ytai/PixieGuitar/hardware/Controller.brd

## EAGLE design hardware/Controller.brd (2016-02-16)

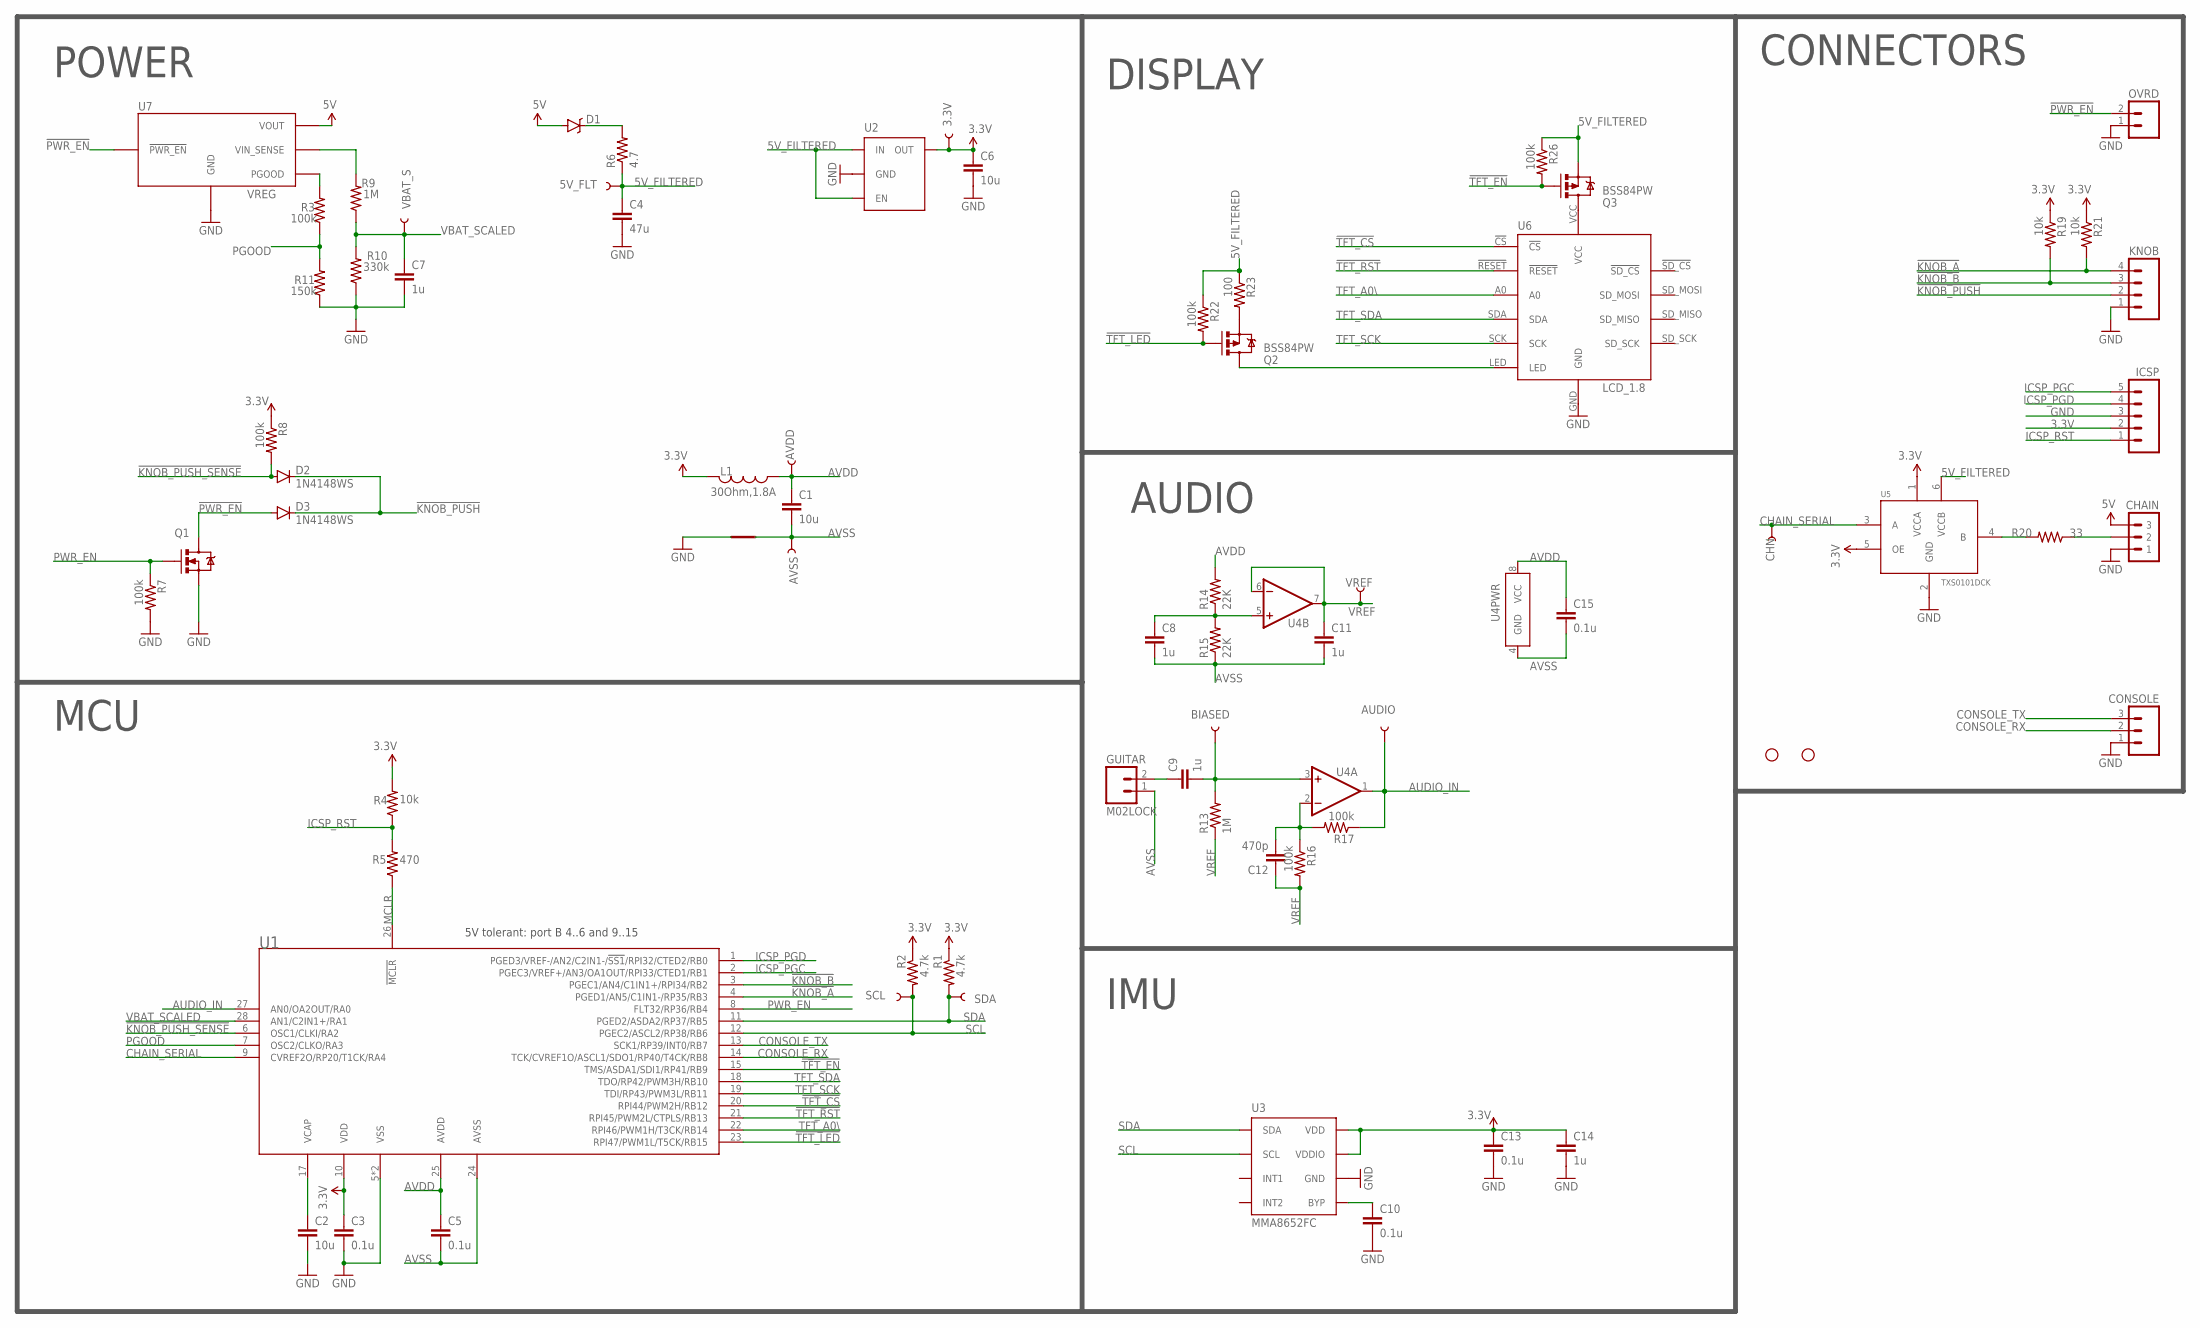
[picture p1: schematic Controller.sch]

Parts:
3.3V, 5V_FLT: TEST-POINT3; PAD.03X.03
AUDIO: TEST-POINT3; PAD.03X.03
AVDD: TEST-POINT3; PAD.03X.03
AVSS: TEST-POINT3; PAD.03X.03
BIASED: TEST-POINT3; PAD.03X.03
C1, C2: 10u; 0805
C3, C5, C10, C13, C15: 0.1u; 0603-CAP
C4: 47u; 1206
C6: 10u; 0603-CAP
C7, C8, C9, C11, C14: 1u; 0603-CAP
C12: 470p; 0603-CAP
CHAIN: M030.1PWR+SIG; 1X03-0.1PWR+SIG
CHN: TEST-POINT3; PAD.03X.03
CONSOLE: M03LOCK; 1X03_LOCK
D1: DB2J20900L; SOD-323
D2, D3: 1N4148WS; SOD-323
GUITAR: M02LOCK; 1X02_LOCK
ICSP: M05LOCK; 1X05_LOCK
JP1, JP2: STAND-OFF
KNOB: M04LOCK; 1X04_LOCK
L1: 30Ohm,1.8A; 0603
OVRD: M02LOCK; 1X02_LOCK
Q1: MOSFET-NCHANNEL2N7002PW; SOT323
Q2, Q3: BSS84PW; SOT323
R1, R2: 4.7k; 0603-RES
R3, R7, R8, R16, R17, R22, R26: 100k; 0603-RES
R4, R19, R21: 10k; 0603-RES
R5: 470; 0603-RES
R6: 4.7; 0603-RES
R9, R13: 1M; 0603-RES
R10: 330k; 0603-RES
R11: 150k; 0603-RES
R14, R15: 22K; 0603-RES
R20: 33; 0603-RES
R23: 100; 0603-RES
SCL: TEST-POINT3; PAD.03X.03
SDA: TEST-POINT3; PAD.03X.03
SH1: SHORT; SHORT_TOP-8
U1: DSPIC33EPXXXMC202/502/PT; QFN-S-28
U2: MIC5365YC5; SC70
U3: MMA8652FC; 10-VFDFN
U4: MCP6002MS; MSOP-8
U5: TXS0101DCK; SC70-6
U6: LCD_1.8
U7: VREG
VBAT_S: TEST-POINT3; PAD.03X.03
VREF: TEST-POINT3; PAD.03X.03

Connections:
3.3V: 3.3V.P$1, C3.1, C6.1, C13.1, C14.1, ICSP.2, L1.2, R1.1, R2.1, R4.2, R8.1, R19.1, R21.1, U1.10 (VDD), U2.5 (OUT), U3.1 (VDD), U3.8 (VDDIO), U5.1 (VCCA), U5.5 (OE)
5V: CHAIN.P$3 (3), D1.A, U7.VOUT
5V_FILTERED: 5V_FLT.P$1, C4.1, Q3.2 (S), R6.1, R22.1, R23.1, R26.1, U2.1 (IN), U2.3 (EN), U5.6 (VCCB)
!KNOB_A: KNOB.4, R21.2, U1.4 (PGED1/AN5/C1IN1-/RP35/RB3)
!KNOB_B: KNOB.3, R19.2, U1.3 (PGEC1/AN4/C1IN1+/RPI34/RB2)
!KNOB_PUSH: D2.C, D3.C, KNOB.2
!KNOB_PUSH_SENSE: D2.A, R8.2, U1.6 (OSC1/CLKI/RA2)
!PWR_EN: D3.A, OVRD.2, Q1.3 (D), U7.!EN (!PWR_EN)
!TFT_CS: U1.20 (RPI44/PWM2H/RB12), U6.!CS
!TFT_EN: Q3.1 (G), R26.2, U1.15 (TMS/ASDA1/SDI1/RP41/RB9)
!TFT_LED: Q2.1 (G), R22.2, U1.23 (RPI47/PWM1L/T5CK/RB15)
!TFT_RST: U1.21 (RPI45/PWM2L/CTPLS/RB13), U6.!RESET
AUDIO_IN: AUDIO.P$1, R17.1, U1.27 (AN0/OA2OUT/RA0), U4.1 (OUT)
AVDD: AVDD.P$1, C1.1, C5.1, C15.1, L1.1, R14.2, U1.25 (AVDD), U4.8 (VCC)
AVSS: AVSS.P$1, C1.2, C5.2, C8.2, C11.2, C15.2, GUITAR.1, R15.1, SH1.2, U1.24 (AVSS), U4.4 (GND)
CHAIN_SERIAL: CHN.P$1, U1.9 (CVREF2O/RP20/T1CK/RA4), U5.3 (A)
CONSOLE_RX: CONSOLE.2, U1.14 (TCK/CVREF1O/ASCL1/SDO1/RP40/T4CK/RB8)
CONSOLE_TX: CONSOLE.3, U1.13 (SCK1/RP39/INT0/RB7)
GND: C2.2, C3.2, C4.2, C6.2, C7.2, C10.2, C13.2, C14.2, CHAIN.P$1 (1), CONSOLE.1, ICSP.3, KNOB.1, OVRD.1, Q1.2 (S), R7.2, R10.1, R11.1, SH1.1, U1.5 (VSS), U1.16 (VSS), U2.2 (GND), U3.6 (GND), U3.7 (GND), U3.9 (GND), U5.2 (GND), U6.GND, U7.GND_OUT (GND)
ICSP_PGC: ICSP.5, U1.2 (PGEC3/VREF+/AN3/OA1OUT/RPI33/CTED1/RB1)
ICSP_PGD: ICSP.4, U1.1 (PGED3/VREF-/AN2/C2IN1-/!SS1!/RPI32/CTED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)
ICSP_RST: ICSP.1, R4.1, R5.2
MCLR: R5.1, U1.26 (!MCLR)
unnamed: C8.1, R14.1, R15.2, U4.5 (+IN)
unnamed: D1.C, R6.2
unnamed: C9.1, GUITAR.2
unnamed: C12.2, R16.1, R17.2, U4.2 (-IN)
unnamed: C2.1, U1.17 (VCAP)
unnamed: R20.2, U5.4 (B)
unnamed: BIASED.P$1, C9.2, R13.2, U4.3 (+IN)
unnamed: R3.2, U7.PGOOD
unnamed: Q2.3 (D), U6.LED
unnamed: Q3.3 (D), U6.VCC
unnamed: Q2.2 (S), R23.2
unnamed: C10.1, U3.4 (BYP)
unnamed: CHAIN.P$2 (2), R20.1
PGOOD: R3.1, R11.2, U1.7 (OSC2/CLKO/RA3)
PWR_EN: Q1.1 (G), R7.1, U1.8 (FLT32/RP36/RB4)
SCL: R2.2, SCL.P$1, U1.12 (PGEC2/ASCL2/RP38/RB6), U3.2 (SCL)
SDA: R1.2, SDA.P$1, U1.11 (PGED2/ASDA2/RP37/RB5), U3.10 (SDA)
TFT_A0\: U1.22 (RPI46/PWM1H/T3CK/RB14), U6.A0
TFT_SCK: U1.19 (TDI/RP43/PWM3L/RB11), U6.SCK
TFT_SDA: U1.18 (TDO/RP42/PWM3H/RB10), U6.SDA
VBAT_SCALED: C7.1, R9.1, R10.2, U1.28 (AN1/C2IN1+/RA1), VBAT_S.P$1
VBAT_SENSE: R9.2, U7.VSENSE (VIN_SENSE)
VREF: C11.1, C12.1, R13.1, R16.2, U4.6 (-IN), U4.7 (OUT), VREF.P$1

Notes on the sheet:
5V tolerant: port B 4..6 and 9..15
POWER
IMU
AUDIO
DISPLAY
CONNECTORS
MCU

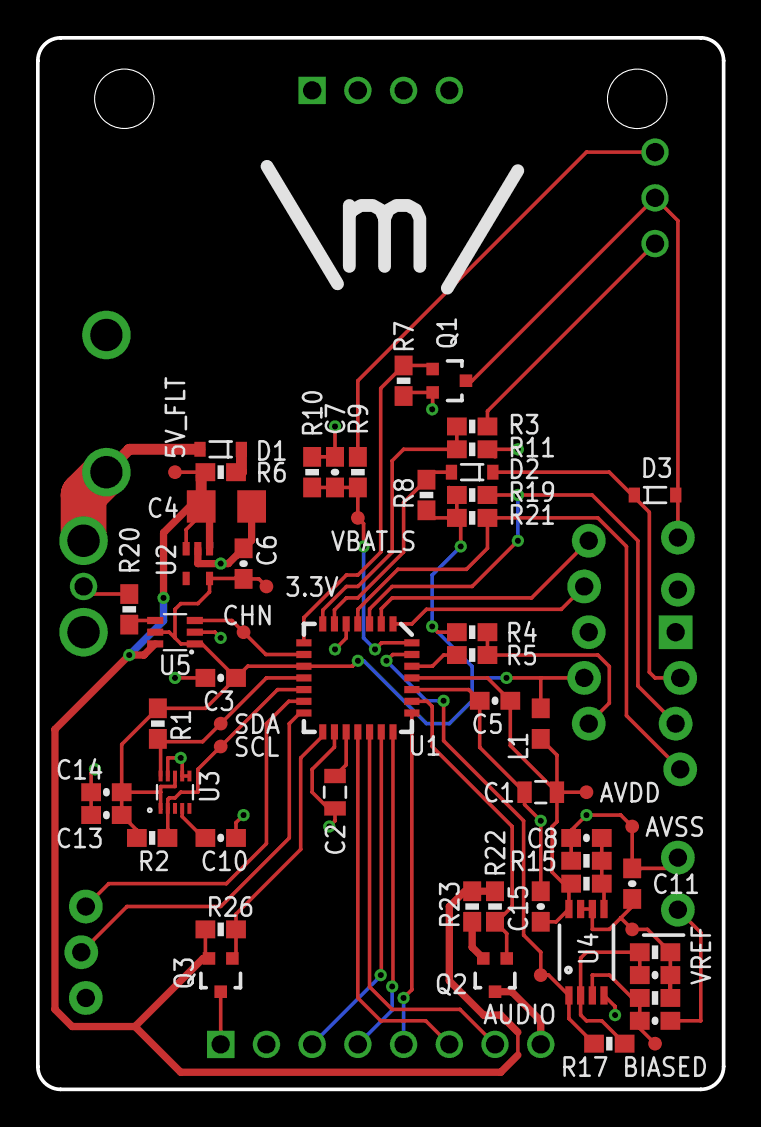
[picture p2: board Controller.brd from above]

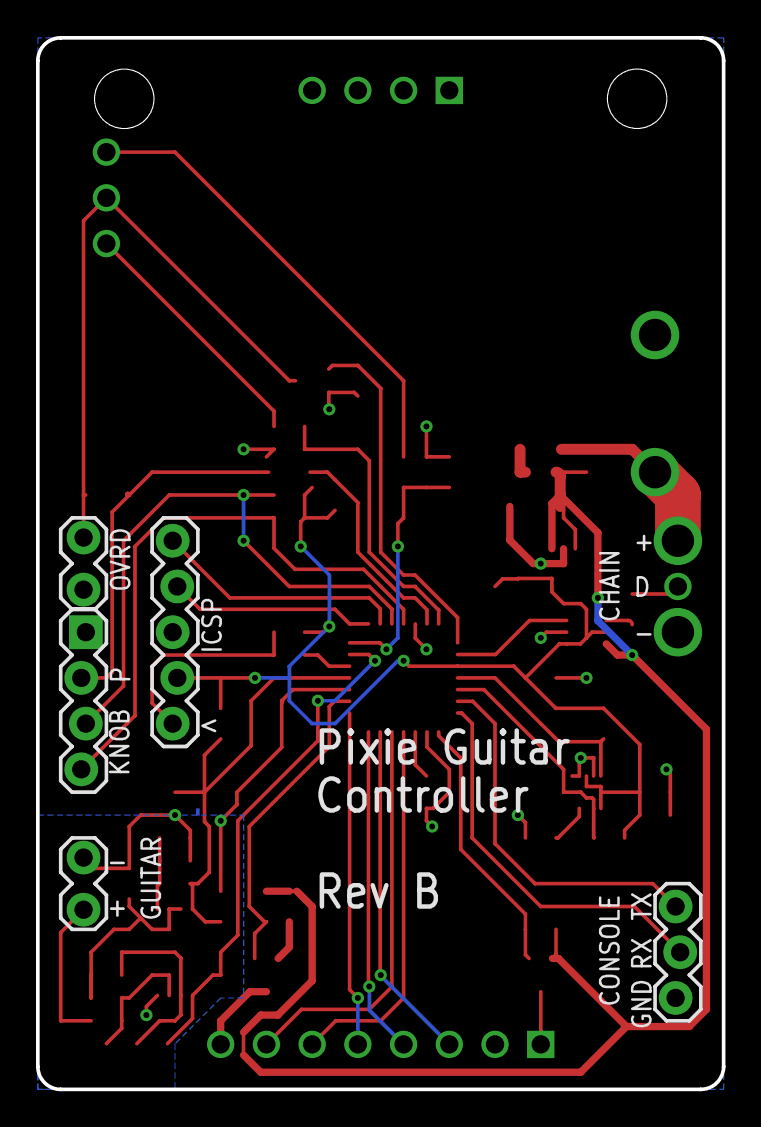
[picture p3: board Controller.brd from below]

Board: 2 copper layers, 38.1 x 58.4 mm, 71 parts (8 on the bottom side), 46 nets.
