ytai/PixieGuitar/hardware/vreg.brd

## EAGLE design hardware/vreg.brd (2015-12-07)

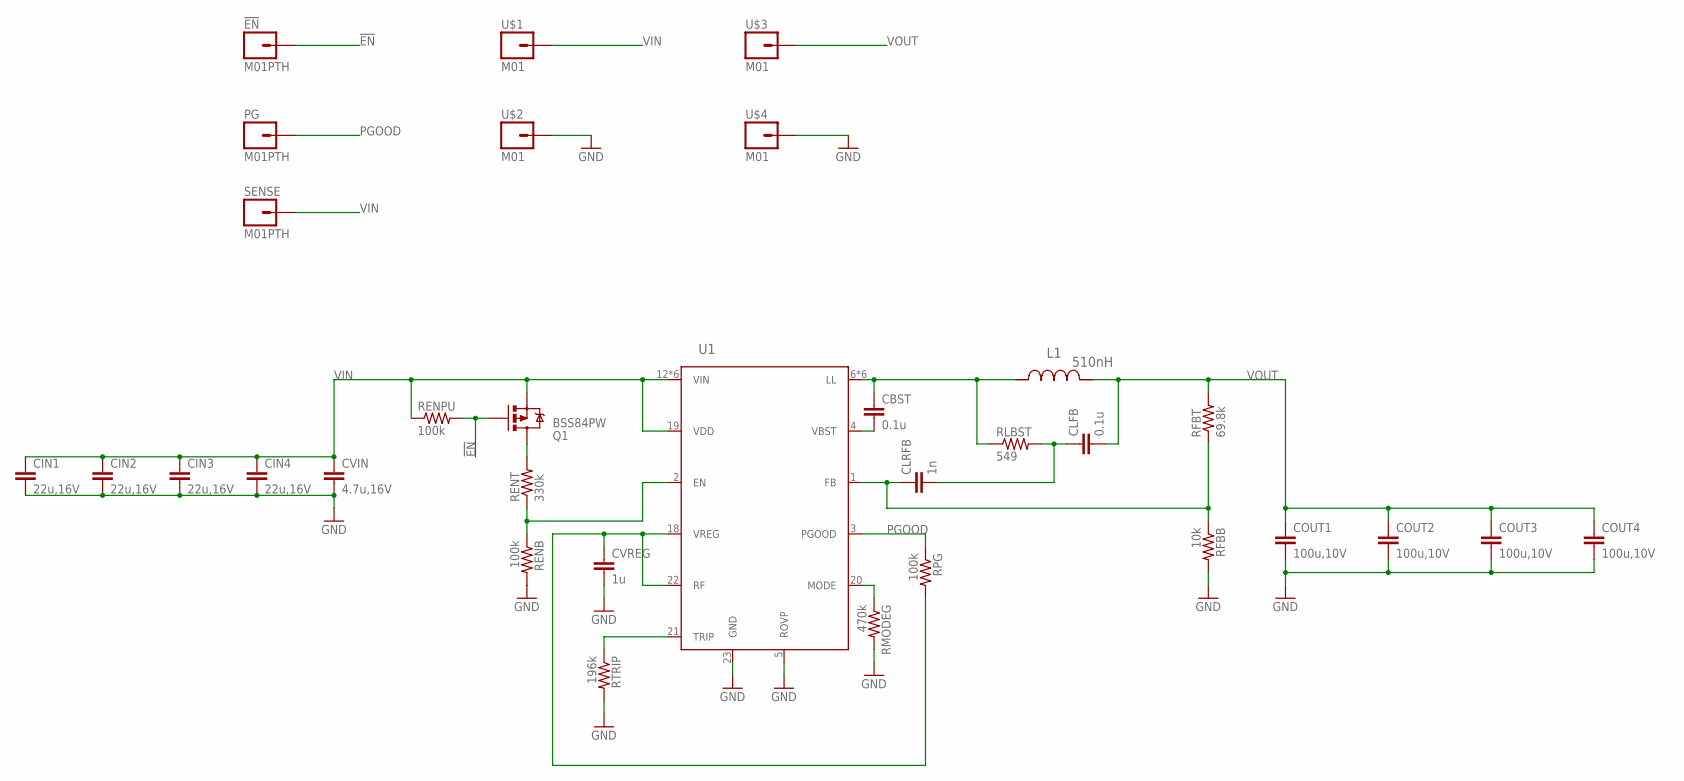
[picture p4: schematic vreg.sch]

Parts:
!EN: M01PTH; 1X01
CBST: 0.1u; 0603-CAP
CIN1, CIN2, CIN3, CIN4: 22u,16V; 1210
CLFB: 0.1u; 0603-CAP
CLRFB: 1n; 0603-CAP
COUT1, COUT2, COUT3, COUT4: 100u,10V; 1210
CVIN: 4.7u,16V; 1206
CVREG: 1u; 0603-CAP
L1: 510nH; FP1107
PG: M01PTH; 1X01
Q1: BSS84PW; SOT323
RENB: 100k; 0603-RES
RENPU: 100k; 0603-RES
RENT: 330k; 0603-RES
RFBB: 10k; 0603-RES
RFBT: 69.8k; 0603-RES
RLBST: 549; 0603-RES
RMODEG: 470k; 0603-RES
RPG: 100k; 0603-RES
RTRIP: 196k; 0603-RES
SENSE: M01PTH; 1X01
U1: TPS53319DQPR; DQP0022A
U$1, U$2, U$3, U$4: M01; PIN_16AWG

Connections:
!EN: !EN.1, Q1.1 (G), RENPU.2
GND: CIN1.2, CIN2.2, CIN3.2, CIN4.2, COUT1.2, COUT2.2, COUT3.2, COUT4.2, CVIN.2, CVREG.2, RENB.2, RFBB.2, RMODEG.2, RTRIP.2, U1.5 (ROVP), U1.23 (GND), U$2.1, U$4.1
LL: CBST.1, L1.1, RLBST.1, U1.6 (LL), U1.7 (LL), U1.8 (LL), U1.9 (LL), U1.10 (LL), U1.11 (LL)
unnamed: RMODEG.1, U1.20 (MODE)
unnamed: RENB.1, RENT.1, U1.2 (EN)
unnamed: Q1.3 (D), RENT.2
unnamed: CVREG.1, RPG.2, U1.18 (VREG), U1.22 (RF)
unnamed: RTRIP.1, U1.21 (TRIP)
unnamed: CBST.2, U1.4 (VBST)
unnamed: CLFB.1, CLRFB.2, RLBST.2
unnamed: CLRFB.1, RFBB.1, RFBT.1, U1.1 (FB)
PGOOD: PG.1, RPG.1, U1.3 (PGOOD)
VIN: CIN1.1, CIN2.1, CIN3.1, CIN4.1, CVIN.1, Q1.2 (S), RENPU.1, SENSE.1, U1.12 (VIN), U1.13 (VIN), U1.14 (VIN), U1.15 (VIN), U1.16 (VIN), U1.17 (VIN), U1.19 (VDD), U$1.1
VOUT: CLFB.2, COUT1.1, COUT2.1, COUT3.1, COUT4.1, L1.2, RFBT.2, U$3.1

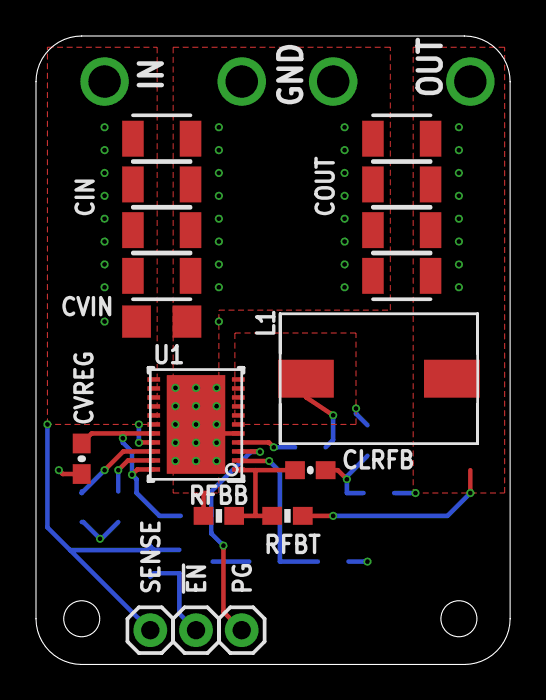
[picture p5: board vreg.brd from above]

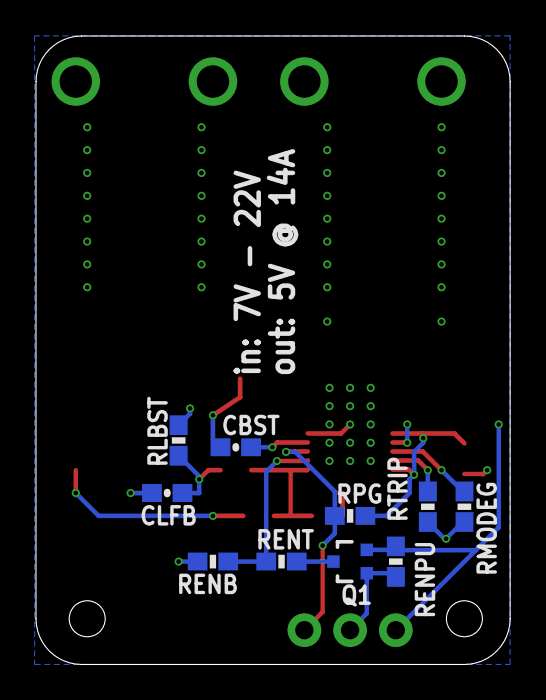
[picture p6: board vreg.brd from below]

Board: 4 copper layers, 26.3 x 34.9 mm, 32 parts (10 on the bottom side), 14 nets.
