ytai/PixieGuitar/software/PixieGuitar.X/main.c

#include <stdio.h>

#include <xc.h>

#include <FreeRTOS.h>
#include <task.h>

#include "app.h"
#include "chain.h"
#include "clock.h"
#include "demo_app.h"
#include "i2c.h"
#include "main_menu_app.h"
#include "module.h"
#include "power.h"
#include "shell_task.h"
#include "splash_app.h"

static MainMenuApp main_menu_app;
static SplashApp splash_app;

int main(int argc, char** argv) {
  PowerOn();

  ClockInit();

  ANSELA = 0;
  ANSELB = 0;
  SPLIM = 0xFFFF;  // TODO: implement proper handling of SPLIM.

  ModuleInit();
  I2cInit();
  ShellTaskInit();

  App * first = MainMenuAppInit(&main_menu_app);
  // Comment out the next line to skip splash.
  first = SplashAppInit(&splash_app, first);

  AppTaskInit(first);

  vTaskStartScheduler();
}

void vApplicationIdleHook() {
    asm volatile("PWRSAV #1");
}
