ytai/PixieGuitar/software/PixieGuitar.X/main_menu_app.h

#ifndef MAIN_MENU_APP_H
#define	MAIN_MENU_APP_H

#include "text_widget.h"
#include "vertical_widget_list.h"
#include "widget_app.h"

typedef struct {
  WidgetApp app;

  VerticalWidgetList list;
  TextWidget texts[7];
  Widget * widgets[7];
} MainMenuApp;

App * MainMenuAppInit(MainMenuApp * instance);

#endif  // MAIN_MENU_APP_H
