ytai/PixieGuitar/(commit log)

2015-12-07 Initial commit - voltage regulator
    [vreg.bom.csv, vreg.brd, vreg.sch]
2016-01-06 Initial commit of the controller board
    [Controller.brd, Controller.sch]
2016-01-06 Commit the gerbers for Controller rev A
2016-01-26 hardware: Change in resistor values in analog section
    [Controller.brd, Controller.sch]
2016-02-16 Add docs
    [VREG Calcs.ods]
2016-02-16 hardware: One of the test-points wasn't routed
    [Controller.brd]
2016-02-16 hardware: Remove R18
    It was wrong to pull to 3.3V behind the diode, resulting in always enabling the VREG
    [Controller.brd, Controller.sch]
2016-02-16 hardware: Route TFT SPI pins to RPx pins
    Previously, the MCU pins used for TFT SPI could not be driven by a SPI peripheral.
    [Controller.brd, Controller.sch]
2016-02-16 hardware: divide PGOOD to be 3.3V
    It is a 5V signal, previously fed into a non-5V tolerant pin.
    [Controller.brd, Controller.sch]
2016-02-16 hardware: Round controller board corners
    [Controller.brd]
2016-02-16 hardware: Bump revision number to B
    [Controller.brd]
2016-04-24 Refactor app framework
    A more generic application framework supporting multiple different applications.
2016-04-26 Fix integer constant overflow in ticker
    [analog.h, ticker.c]
2016-05-02 Add title bar
    Also, made some changes to how application drawing is done:
    Screen is no longer cleared by the framework upon resume, it is
    now the app's responsibility.
    The title bar persists across apps.
    [app.c, app.h, demo_app.c, gfx.c, gfx.h, title_bar.c, title_bar.h, vertical_widget_list.c]
2016-05-17 software: Use PRNG in demo app
    Choose a random LED each step
2016-05-17 software: Refactor commands to be value types
    Added a NOP command to replace NULL.
    [app.c, app.h, main_menu_app.c, main_menu_app.h, text_widget.c, text_widget.h]
2016-05-17 software: Add power off menu item
2016-05-17 software: Always check battery voltage
    This is no longer an app request, since we need this for the framework
    (title bar, auto-off).
    [app.c, app.h, demo_app.c]
2016-05-17 software: Change accelerometer handling, screen flipping and app redraw
    - App now gets the neck tilt in degrees rather than raw acc reading.
    - Framework handles flipping the screen. As result, the force redraw
    signal needs to be generated by the framework and it turns out that
    it is anyway better than having every app implement the same logic.
    [app.c, app.h, demo_app.c, rainbow_app.c, rainbow_app.h, title_bar.c, title_bar.h, widget_app.c]
2016-05-17 software: Fix bug in vertical widget list
    Would not wrap around the start.
    [enum_widget.c, util.h, vertical_widget_list.c]
2016-05-17 software: IMU improvements
    - Catch IMU hangs.
    - Better calculation of tilt angles.
2016-05-17 software: Centralized handling of chain
    App task now writes to the chain every tick, so it turns
    off immediately when exiting apps. It also saves each app
    from having to have its own buffer.
2016-05-17 software: Add power measurement
2016-05-18 software: Power off on empty battery
2016-05-18 software: Added splash up
    Protection against inadvertent power up
